Brandon-Valley/TSAL-Control-Board/Tractive System Light Control Board.dxf

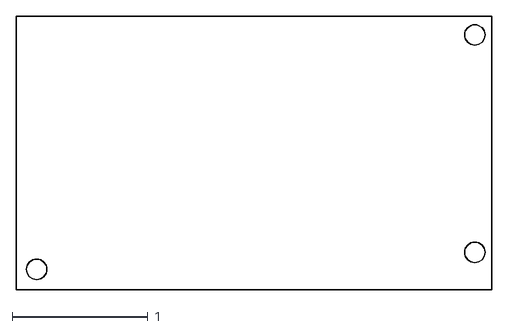
[picture p1: CAD file, 2016-03-18]
Tractive System Light Control Board.dxf
3.50 x 2.01
