Brandon-Valley/TSAL-Control-Board/Tractive System Light Control Board.brd

## EAGLE design Tractive System Light Control Board.brd (2016-05-09)

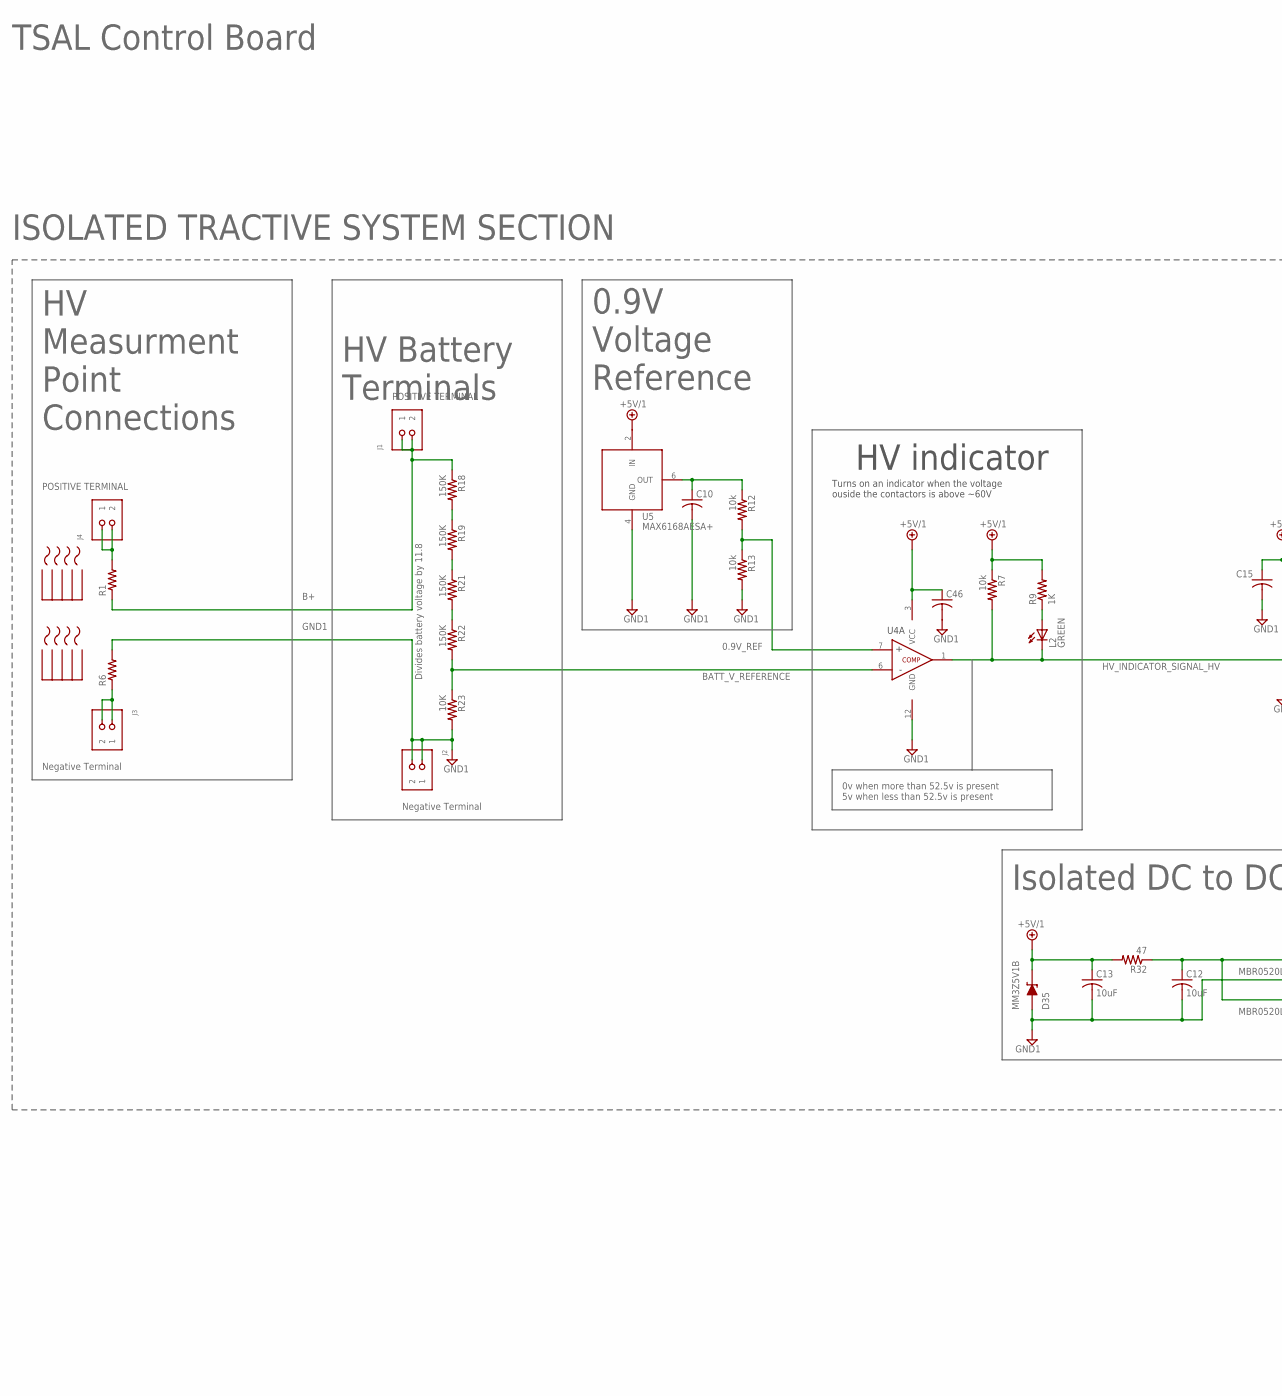
[picture p2: schematic Tractive System Light Control Board.sch, part in row 1, column 1]

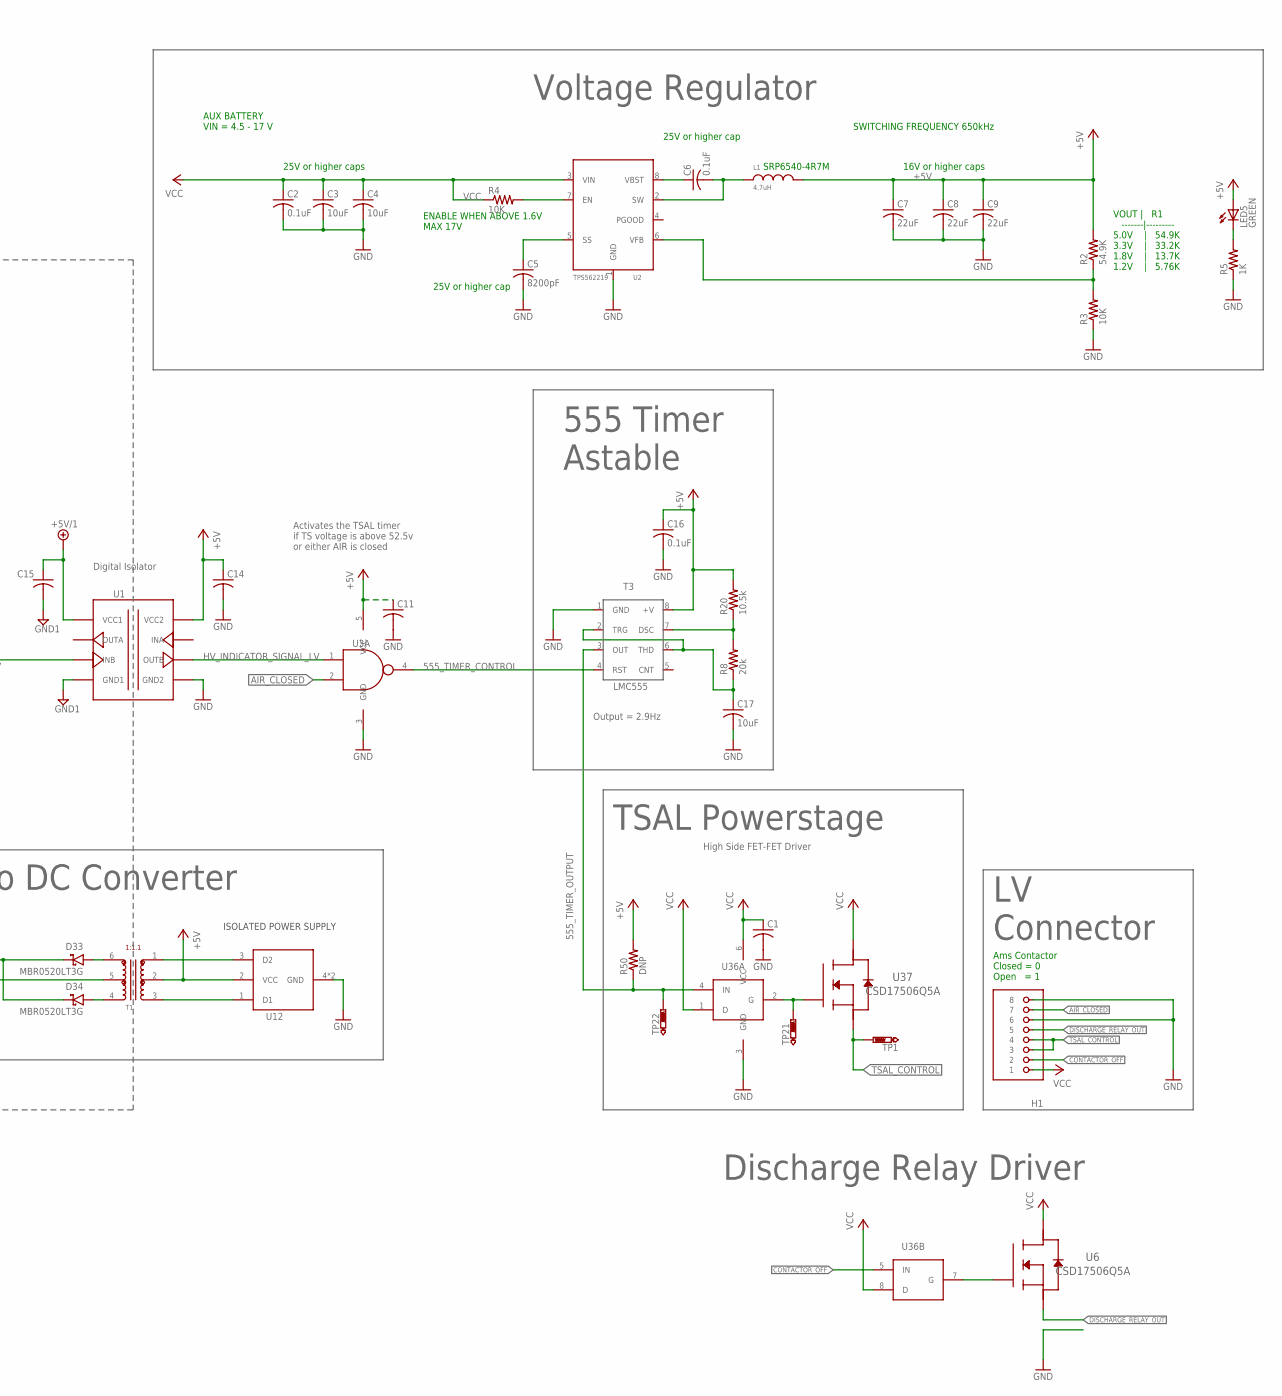
[picture p3: schematic Tractive System Light Control Board.sch, part in row 1, column 2]

Parts:
C1, C10, C11, C14, C15, C46: 0.1uF; C0805; MPN C1005X7R1E104K050BB
C2, C6: 0.1uF; C0805; PARTNO GRM21BR71E104KA01L
C3, C4, C17: 10uF; C0805; PARTNO GRM21BR61E106KA73L
C5: 8200pF; C0805; PARTNO C0805C822K5RACTU
C7, C8, C9: 22uF; C0805; PARTNO C2012JB1E226M125AC
C12, C13: 10uF; C0805; MPN C1005X7R1E104K050BB
C16: 0.1uF; C0805; PARTNO 08053C104KAT2A
D33, D34: MBR0520LT3G; SOD-123; PARTNO MBR0520LT3G
D35: MM3Z5V1B; SOD323F; PARTNO MM3Z5V1B
H1: MOLEX_CLIKMATE-8-VERTICAL-5025841170; MOLEX-CLIKMATE-8-VERTICAL-HEADER; PARTNO 5025840870
J1, J2, J3, J4: MOLEX_CLICKMATE-2-VERTICAL; MOLEX-CLIKMATE-2-VERTICAL-HEADER; PARTNO 5025840270
L1: 4.7uH; SRP6540; PARTNO SRP6540-4R7M
L2: GREEN; CHIPLED_0805; PARTNO 598-8170-107F
LED5: GREEN; CHIPLED_0805; PARTNO 598-8170-107F
R1, R6: RTO020F10001JTE3; TO-220-2; PARTNO RTO020F10001JTE3
R2: 54.9K; R0805; PARTNO ERA-6AEB5492V
R3, R4, R23: 10K; R0805; PARTNO ERJ-6ENF1002V
R5, R9: 1K; R0805; PARTNO ERJ-6ENF1001V
R7, R12, R13: 10k; R0805; PARTNO ERJ-6ENF1002V
R8: 20k; R0805; PARTNO ERJ-6ENF2002V
R18, R19, R21, R22: 150K; R0805; PARTNO ERJ-6ENF1503V
R20: 10.5k; R0805; PARTNO ERJ-6ENF1052V
R32: 47; R0805; PARTNO ERA-6AEB470V
R50: DNP; R0805
T1: 750313734; WURTH-750313734; PARTNO 750313734
T3: LMC555; PARTNO LMC555CMM/NOPB
TP1, TP21, TP22: PTR1TP20R; TP20R
U1: ISO7221; ISO722X; PARTNO ISO7221CDR
U2: TPS562219; PARTNO TPS562219DDFT
U3: SN74LVC1G00DRL; LITTLE_LOGIC_BASIC_DRL; PARTNO SN74LVC1G00DRLR
U4: LM139; D14; PARTNO LM139DR
U5: MAX6168AESA+; SOIC-8; PARTNO MAX6168AESA+
U6: CSD17506Q5A; SON_5X6
U12: SN6501DBVR; SN6501DBV; PARTNO SN6501DBVR
U36: LTC1155; LT-SOL8; PARTNO LTC1155CS8#PBF
U37: CSD17506Q5A; SON_5X6; PARTNO CSD17506Q5A
U$1, U$2: 581002B02500G; AAVID-581X; PARTNO 581002B02500G

Connections:
0.9V_REF: R12.2, R13.1, U4.7 (+)
1.8V_REF: C10.1, R12.1, U5.6 (OUT)
555_TIMER_CONTROL: T3.4 (RST), U3.4 (OUT)
555_TIMER_OUTPUT: R50.1, T3.3 (OUT), TP22.TP, U36.4 (IN)
+5V: C7.1, C8.1, C9.1, C11.1, C14.1, C16.1, L1.P$2, LED5.A, R2.2, R20.2, R50.2, T1.2, T3.8 (+V), U1.P$8 (VCC2), U3.5 (VCC), U12.2 (VCC)
+5V/1: C13.1, C15.1, C46.1, D35.CATHODE, R7.1, R9.2, R32.2, U1.P$1 (VCC1), U4.3 (VCC), U5.2 (IN)
AIR_CLOSED: H1.7, U3.2 (IN2)
B+: J1.1, J1.2, R1.P$1, R18.1
BATT_V_REFERENCE: R22.2, R23.1, U4.6 (-)
CONTACTOR_OFF: H1.2, U36.5 (IN)
DISCHARGE_RELAY_OUT: H1.5, U6.1 (S), U6.2 (S), U6.3 (S)
GND: C1.2, C2.2, C3.2, C4.2, C5.2, C7.2, C8.2, C9.2, C11.2, C14.2, C16.2, C17.2, H1.6, H1.8, R3.1, R5.1, T3.1 (GND), U1.P$5 (GND2), U2.1 (GND), U3.3 (GND), U12.4 (GND), U12.5 (GND), U36.3 (GND)
GND1: C10.2, C12.2, C13.2, C15.2, C46.2, D35.ANODE, J2.1, J2.2, R6.P$2, R13.2, R23.2, T1.5, U1.P$4 (GND1), U4.12 (GND), U5.4 (GND)
HV_INDICATOR_SIGNAL_HV: L2.C, R7.2, U1.P$3 (INB), U4.1 (OUT)
HV_INDICATOR_SIGNAL_LV: U1.P$6 (OUTB), U3.1 (IN1)
unnamed: R4.2, U2.7 (EN)
unnamed: LED5.C, R5.2
unnamed: TP21.TP, U36.2 (G), U37.4 (G)
unnamed: L2.A, R9.1
unnamed: J4.1, J4.2, R1.P$2
unnamed: J3.1, J3.2, R6.P$1
unnamed: U6.4 (G), U36.7 (G)
unnamed: R8.2, R20.1, T3.7 (DSC)
unnamed: C17.1, R8.1, T3.2 (TRG), T3.6 (THD)
unnamed: R18.2, R19.1
unnamed: R19.2, R21.1
unnamed: R21.2, R22.1
unnamed: T1.1, U12.3 (D2)
unnamed: T1.3, U12.1 (D1)
unnamed: D33.A, T1.6
unnamed: C12.1, D33.K, D34.K, R32.1
unnamed: D34.A, T1.4
SS_5V1: C5.1, U2.5 (SS)
SW_5V2: C6.2, L1.P$1, U2.2 (SW)
TSAL_CONTROL: H1.3, H1.4, TP1.TP, U37.1 (S), U37.2 (S), U37.3 (S)
VBST_5V1: C6.1, U2.8 (VBST)
VCC: C1.1, C2.1, C3.1, C4.1, H1.1, R4.1, U2.3 (VIN), U6.5 (D), U6.6 (D), U6.7 (D), U6.8 (D), U6.PAD (D), U6.PAD1 (D), U6.VIA1 (D), U6.VIA2 (D), U6.VIA3 (D), U6.VIA4 (D), U6.VIA5 (D), U6.VIA6 (D), U6.VIA7 (D), U6.VIA8 (D), U6.VIA9 (D), U36.1 (D), U36.6 (VCC), U36.8 (D), U37.5 (D), U37.6 (D), U37.7 (D), U37.8 (D), U37.PAD (D), U37.PAD1 (D), U37.VIA1 (D), U37.VIA2 (D), U37.VIA3 (D), U37.VIA4 (D), U37.VIA5 (D), U37.VIA6 (D), U37.VIA7 (D), U37.VIA8 (D), U37.VIA9 (D)
VFB_5V1: R2.1, R3.2, U2.6 (VFB)

Notes on the sheet:
HV indicator
Turns on an indicator when the voltage ouside the contactors is above ~60V
555 Timer Astable
High Side FET-FET Driver
TSAL Powerstage
Ams Contactor Closed = 0 Open = 1
AUX BATTERY VIN = 4.5 - 17 V
VOUT | R1 -------|--------- 5.0V | 54.9K 3.3V | 33.2K 1.8V | 13.7K 1.2V | 5.76K
SRP6540-4R7M
SWITCHING FREQUENCY 650kHz
ENABLE WHEN ABOVE 1.6V MAX 17V
25V or higher caps
25V or higher cap
16V or higher caps
Divides battery voltage by 11.8
ISOLATED POWER SUPPLY
Isolated DC to DC Converter
Digital Isolator
Voltage Regulator
TSAL Control Board
Output = 2.9Hz
Activates the TSAL timer if TS voltage is above 52.5v or either AIR is closed
0v when more than 52.5v is present 5v when less than 52.5v is present
POSITIVE TERMINAL
Negative Terminal
ISOLATED TRACTIVE SYSTEM SECTION
HV Battery Terminals
HV Measurment Point Connections
LV Connector
0.9V Voltage Reference
Discharge Relay Driver

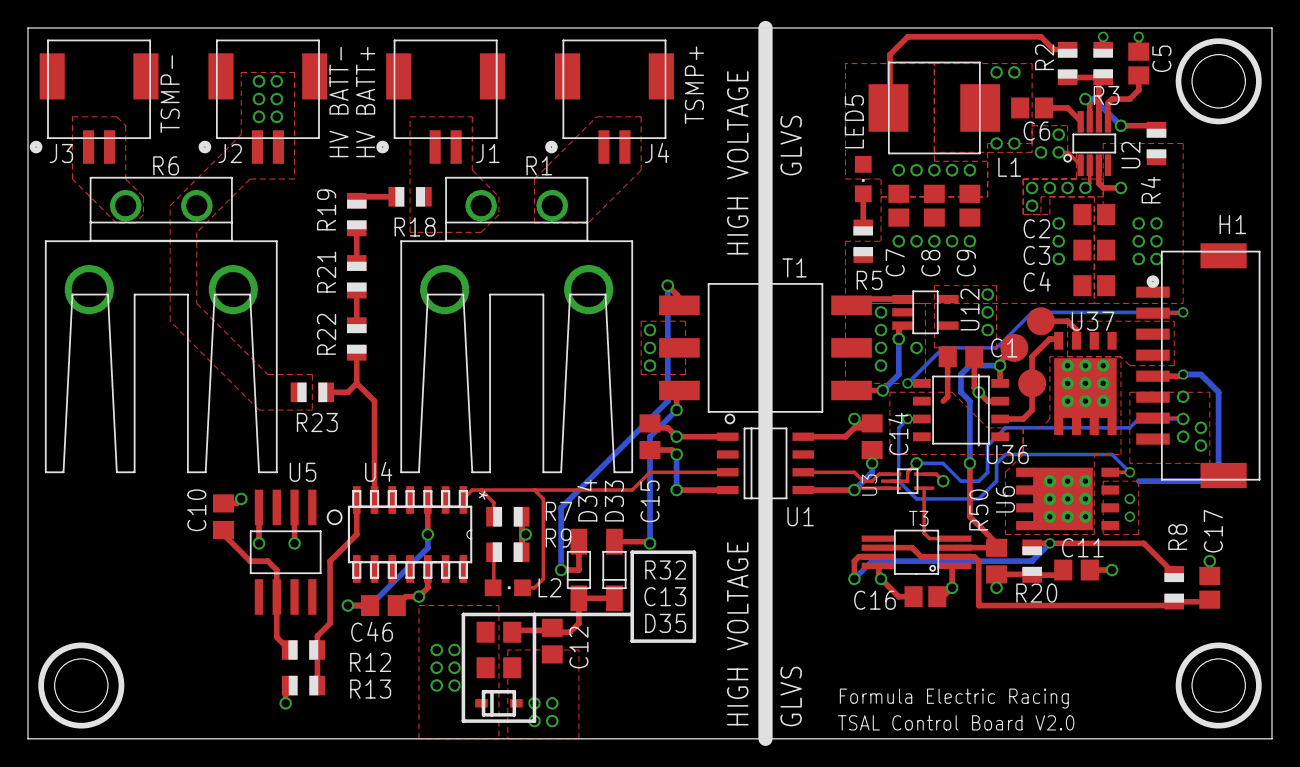
[picture p4: board Tractive System Light Control Board.brd from above]

Board: 4 copper layers, 88.9 x 50.8 mm, 64 parts (0 on the bottom side), 38 nets.
