Brandon-Valley/TSAL-Control-Board/(commit log)

2016-01-04 First Commit: This PCB will control the Tractive System Active Light (TSAL). Light will flash continuously while either there is 60V or more on the high side (when the battery is on), or when a signa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
    [Tractive System Light Control Board.brd, Tractive System Light Control Board.sch]
2016-01-10 Added 55 Timer schematics and DC DC Converter
    [Tractive System Light Control Board.brd, Tractive System Light Control Board.sch]
2016-03-10 Done, ready to start board, changed name to TSAL Control Board
2016-03-10 Mid-design change, about to start deleting things
    [Tractive System Light Control Board.brd, Tractive System Light Control Board.sch]
2016-03-11 Schematic Done
    [Tractive System Light Control Board.brd, Tractive System Light Control Board.sch]
2016-03-13 Layout Done: Need graphic for HV, maybe logo in bottom right corner?
    [Tractive System Light Control Board.brd, Tractive System Light Control Board.sch]
2016-03-17 Added resistors and heat sink to schematic, about to make changes
    [Tractive System Light Control Board.brd, Tractive System Light Control Board.sch]
2016-03-17 Fixed small schematic errors, about to start layout
    [Tractive System Light Control Board.sch]
2016-03-18 Done with layout, about to start BOM
    [Tractive System Light Control Board.brd, Tractive System Light Control Board.sch]
2016-03-18 Layout done
    [Tractive System Light Control Board.brd]
2016-03-18 Small Layout Changes, about to start BOM
    [Tractive System Light Control Board.brd]
2016-03-18 BOM Done, files next
    [Tractive System Light Control Board.brd, Tractive System Light Control Board.dxf, Tractive System Light Control Board.sch]
2016-03-20 BOM Done, about to generate files
    [Tractive System Light Control Board.brd, Tractive System Light Control Board.sch]
2016-03-23 Fixed BOM, added MM3Z5V1B
    [Tractive System Light Control Board.brd, Tractive System Light Control Board.sch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]
2016-03-26 Fixed comparator and BOM, about to generate files
    [Tractive System Light Control Board.brd, Tractive System Light Control Board.sch]
2016-03-26 DONE: added files, ready for order
    [Tractive System Light Control Board_BottomCopper.GBL, Tractive System Light Control Board_BottomMask.GBS, Tractive System Light Control Board_Drill.XLN, Tractive System Light Control Board_TopCopper.GTL, Tractive System Light Control Board_TopMask.GTS]
2016-03-27 A few minor layout tweaks. Regenerated gerbers and BOM
    [Tractive System Light Control Board.brd, Tractive System Light Control Board.sch, Tractive System Light Control Board_OrderUploadDigiKey.csv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]
2016-04-20 Fixed 10k Resistors- TSAL Control Board V2.0- Ready To Order
    [Tractive System Light Control Board.brd, Tractive System Light Control Board.sch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]
2016-04-20 Updated BOM, ready to order... again
    [Tractive System Light Control Board.brd, Tractive System Light Control Board.sch]
2016-04-20 Fixed 10K resistor holes- now 1.5 mm, Cams done, ready for order
    [Tractive System Light Control Board.brd, Tractive System Light Control Board.sch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]
2016-04-20 Generated BOM
    [Tractive System Light Control Board_OrderUploadDigiKey.csv]
2016-05-04 Added missing pad connections on high volt side,
    [Tractive System Light Control Board.brd, Tractive System Light Control Board.sch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]
2016-05-04 Fixed pads on high volt side connectors, cams made, ready for re-order
    [Tractive System Light Control Board.sch]
2016-05-08 Added second pin connection to hv connections, regnerated gerbers
    [Tractive System Light Control Board.brd, Tractive System Light Control Board.sch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]
2016-05-09 Added discharge relay driver, regen gerbers
    [Tractive System Light Control Board.brd, Tractive System Light Control Board.sch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]
